benjamin-wilson/NerdNOS/3d/TPSM863257RDXR--3DModel-STEP-510211.STEP

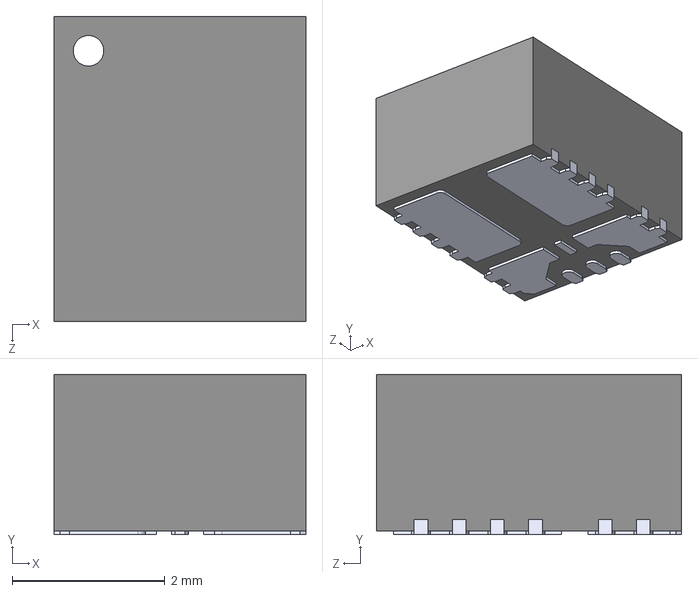
[picture p1: CAD file, 2024-04-07]
3d/TPSM863257RDXR--3DModel-STEP-510211.STEP
3.30 x 2.10 x 4.00 mm
