benjamin-wilson/NerdNOS/NerdNOS.step

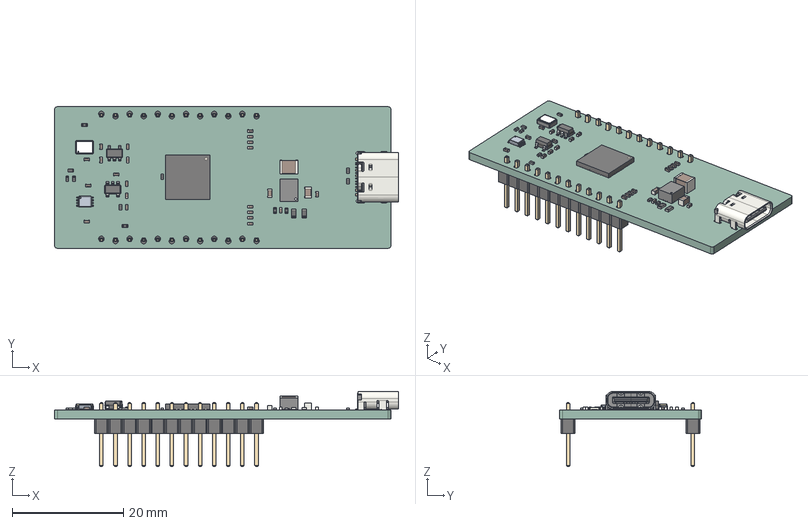
[picture p2: CAD file, 2024-04-30]
NerdNOS.step
62.0 x 25.5 x 13.6 mm
SOT_23_5 x 2
R_0402_1005Metric x 11
C_0402_1005Metric x 21
TPSM863257RDXR
USB_C_Receptacle_16P_TopMnt_Horizontal_GCT_USB4105-xx-A
ECS-327KE
C_1210_3225Metric
R_0603_1608Metric x 2
QFN-44-1EP_8x8mm_Pitch0.65mm
NerdNOS 1.32.1
C_0805_2012Metric
C_0603_1608Metric
PinHeader_1x12_P254mm_Vertical x 2
NerdNOS_PCB
