benjamin-wilson/NerdNOS/3d/oscillator3.2x2.5.step

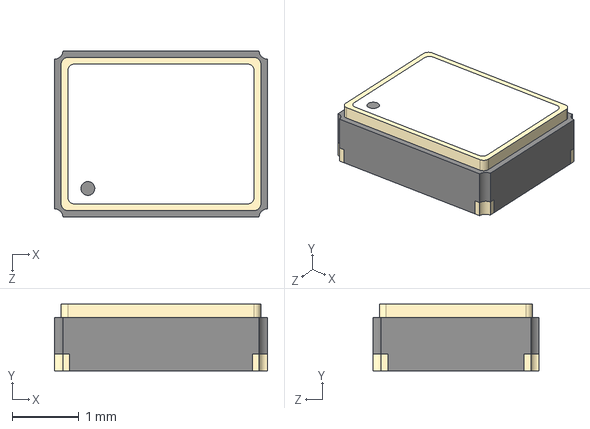
[picture p3: CAD file, 2024-04-07]
3d/oscillator3.2x2.5.step
3.20 x 1.00 x 2.50 mm
