benjamin-wilson/NerdNOS/3d/TXU0202DCUR.step

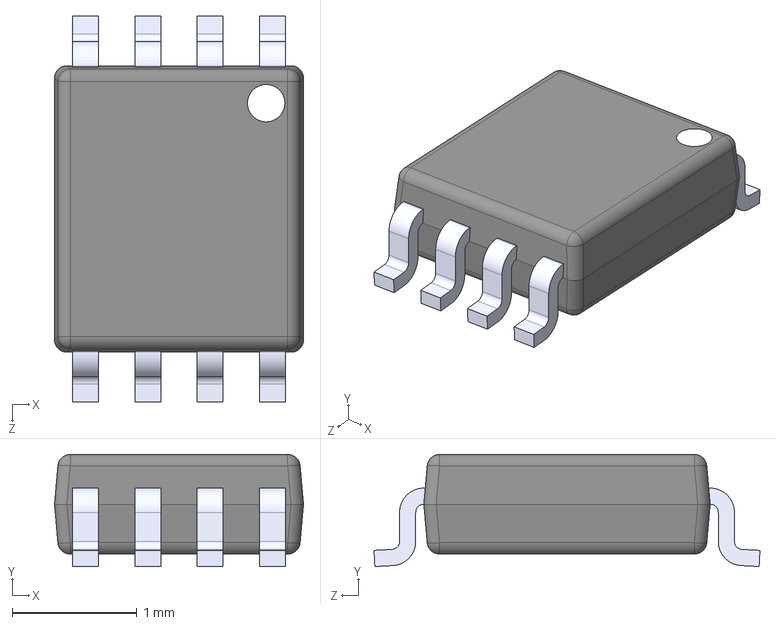
[picture p4: CAD file, 2024-04-07]
3d/TXU0202DCUR.step
2.00 x 0.9 x 3.10 mm
