benjamin-wilson/NerdNOS/(threads)

Thread 1 (2024-04-09):

Correct paste layer for updated BM1397 footprint

benjamin-wilson, 2024-04-09:
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

benjamin-wilson, 2024-04-09:
https://github.com/benjamin-wilson/NerdNOS/commit/f43a1d982fb15be6a6e04d06e5cdaf639e4da696

Closed 2024-04-09.

Thread 2 (2024-05-22):

ASIC 0.8V VDDIO pins are not connected to supply

skot, 2024-05-22:
The net names on the supply and pins don't match.
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

benjamin-wilson, 2024-05-23:
Fixed, second 1v8 was also not connected

Closed 2024-05-23.
