benjamin-wilson/NerdNOS/(commit log)

2024-04-04 routing wok
    [NerdNOS.kicad_pcb, NerdNOS.kicad_sch, T_Display_S3.kicad_sch, bm1397.kicad_sch, power.kicad_sch]
2024-04-04 routing work
    [NerdNOS.kicad_pcb, NerdNOS.kicad_sch, T_Display_S3.kicad_sch, bm1397.kicad_sch, power.kicad_sch]
2024-04-05 happy DRC
    [NerdNOS.kicad_pcb]
2024-04-05 moved asic
    [NerdNOS.kicad_pcb]
2024-04-05 update layout, add 1v8 ldo, remove clock level shifter
    [NerdNOS.kicad_pcb, bm1397.kicad_sch]
2024-04-05 replace inductor, tant cap, remove 3v3
    [NerdNOS.kicad_pcb, NerdNOS.kicad_sch, bm1397.kicad_sch, power.kicad_sch]
2024-04-05 BI pulldown
    [NerdNOS.kicad_pcb, NerdNOS.kicad_sch, T_Display_S3.kicad_sch, bm1397.kicad_sch]
2024-04-06 level shifter
    [NerdNOS.kicad_pcb, NerdNOS.kicad_sch, T_Display_S3.kicad_sch, bm1397.kicad_sch]
2024-04-06 change buck
    [NerdNOS.kicad_pcb, power.kicad_sch]
2024-04-07 routing tweak
    [NerdNOS.kicad_pcb, bm1397.kicad_sch]
2024-04-07 fixed buck ground
    [NerdNOS.kicad_pcb, bm1397.kicad_sch, power.kicad_sch]
2024-04-07 20mm asic keepout
    [NerdNOS.kicad_pcb]
2024-04-07 schematic and symbol cleanup. detached CLKI from ESP32.
    [NerdNOS.kicad_sch, T_Display_S3.kicad_sch, bm1397.kicad_sch, power.kicad_sch]
2024-04-07 added 3d shapes. pcb cleanup
    [NerdNOS.kicad_pcb, NerdNOS.kicad_sch, TPSM863257RDXR--3DModel-STEP-510211.STEP, TXU0202DCUR.step, T_Display_S3.kicad_sch, bm1397.kicad_sch, oscillator3.2x2.5.step, power.kicad_sch]
2024-04-07 TPSM86 footprint
    [NerdNOS.kicad_pcb]
2024-04-07 zone cleanup. DRC, ERC
    [NerdNOS.kicad_pcb, bm1397.kicad_sch, power.kicad_sch]
2024-04-07 added soldermask to ASIC footprint
    [NerdNOS.kicad_pcb]
2024-04-08 refine footprints and parts
    [NerdNOS-B_Cu.gbr, NerdNOS-B_Mask.gbr, NerdNOS-B_Paste.gbr, NerdNOS-B_Silkscreen.gbr, NerdNOS-Edge_Cuts.gbr, NerdNOS-F_Cu.gbr, NerdNOS-F_Mask.gbr, NerdNOS-F_Paste.gbr]
2024-04-09 fix asic paste layer
    [NerdNOS.kicad_pcb]
2024-04-13 compacting pcb to ttgo t3 size
    [NerdNOS.kicad_pcb, NerdNOS.step]
2024-04-13 added value to asic caps
    [NerdNOS.kicad_pcb, bm1397.kicad_sch]
2024-04-17 changed 12 pins to 0.4mm offset
    [NerdNOS-B_Cu.gbr, NerdNOS-B_Mask.gbr, NerdNOS-B_Paste.gbr, NerdNOS-B_Silkscreen.gbr, NerdNOS-Edge_Cuts.gbr, NerdNOS-F_Cu.gbr, NerdNOS-F_Mask.gbr, NerdNOS-F_Paste.gbr]
2024-04-30 fixed 12pin position
    [NerdNOS.kicad_pcb, NerdNOS.step, T_Display_S3.kicad_sch]
2024-05-23 fixed 0v8 and 1v8
    [NerdNOS.kicad_pcb, bm1397.kicad_sch]
